alaa-w/car-production-line-arm-project/Production_Line_Report_Final2.docx

Automated Car Production Line

Using Dual Robotic Arms and Conveyor Belt

Alaa Waheed

___________________________

# Abstract

This report presents the implementation and testing of an automated miniature car production line using two 4-DOF robotic arms, a DC motor-driven conveyor belt, and two Arduino Uno microcontrollers. Each robotic arm is actuated by four MG996R servo motors controlled through a PCA9685 PWM driver via the I2C bus. Object detection is achieved using HC-SR04 ultrasonic sensors, and inter-Arduino communication is realized through direct digital signaling.

The development followed a deliberate kinematics progression: forward kinematics (FK) was applied first to manually derive joint angles from the arm geometry, establishing a theoretical foundation and an initial working configuration. The team then transitioned to inverse kinematics (IK), implementing a geometric 2-DOF planar solver that computes shoulder and elbow angles automatically from a desired Cartesian target position. This transition significantly reduced calibration time and made the system easier to reconfigure when pick or place locations changed. Prior to integrating IK into the final firmware, a dedicated angle-testing sketch was used via the Arduino Serial Monitor to empirically validate individual joint movements and confirm servo behavior — a step that proved essential for correctly tuning the IK target coordinates.

The system successfully demonstrates sequential object transfer: ARM 1 detects an object on the belt, executes a pick-and-place operation, then restarts the belt; ARM 2 detects the object at the second station, signals a belt stop, and completes the second pick-and-place. All motion is executed with smooth servo interpolation to protect mechanical components and ensure positioning accuracy.

# 1. Introduction

Modern automotive manufacturing relies heavily on robotic automation to achieve high throughput, precision, and repeatability. Industrial robotic arms handle tasks such as welding, painting, component assembly, and material transfer on conveyor-based production lines. This project replicates those principles at a prototype scale, exploring the coordination challenges that arise when multiple robotic agents must cooperate around a shared conveyor.

The system consists of two independently controlled 4-DOF robotic arms positioned along a conveyor belt. ARM 1, managed by Arduino 1, performs the first pick-and-place operation; ARM 2, managed by Arduino 2, performs the second. The two microcontrollers communicate via digital signal lines to synchronize belt operation and arm activity, ensuring that only one arm operates at a time and that the belt runs only when no pick-and-place is in progress.

The key objectives of this project are:

- Integrate two commercially available 4-DOF robotic arms with custom control firmware.
- Construct a conveyor belt capable of reliably transporting small objects between arm stations.
- Apply forward kinematics initially to determine joint angles, establishing a theoretical baseline before transitioning to inverse kinematics for automatic angle computation from Cartesian targets.
- Use a dedicated serial-command testing sketch to empirically validate servo angles before committing them to production firmware.
- Implement smooth servo interpolation to ensure safe and accurate motion.
- Establish reliable inter-Arduino communication for system-wide coordination.
- Validate the complete end-to-end automated sequence.

# 2. System Overview

## 2.1 Architecture

The production line is organized as two sequential workstations sharing a single conveyor belt. Arduino 1 controls the belt motor, the first ultrasonic sensor, and ARM 1. Arduino 2 controls the second ultrasonic sensor and ARM 2. A pair of digital signal wires connects the two Arduinos, allowing them to coordinate without a shared clock or serial protocol.

2.2 Operational Sequence

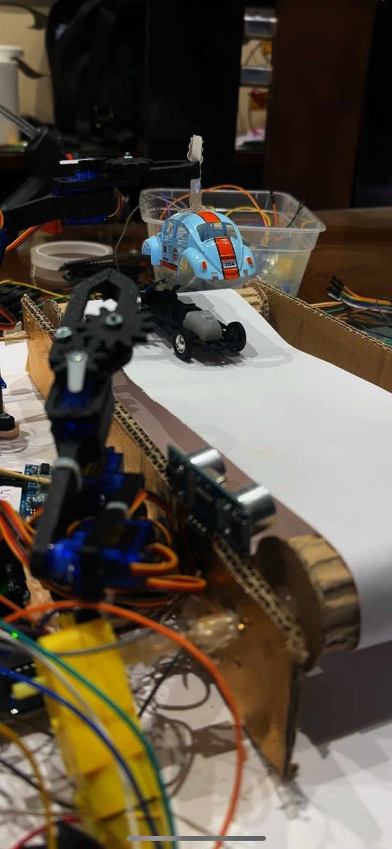
[picture p1: figure]

- Arduino 1 starts the conveyor belt at startup.
- ARM 1's ultrasonic sensor detects an object within 10 cm — belt stops.
- ARM 1 executes its PICK sequence, grasping the object from the belt.
- ARM 1 executes its PUT sequence, placing the object at the intermediate station.
- Arduino 1 restarts the belt; Arduino 2 begins monitoring ARM 2's sensor.
- ARM 2's sensor detects the object within 10 cm — Arduino 2 asserts SIGNAL_OUT (PIN 7) HIGH — Arduino 1 stops the belt.
- ARM 2 executes its PICK and PUT sequences, completing the transfer.
- Both Arduinos halt. The production cycle is complete.

# 3. Hardware

## 3.1 Components

The table below lists all primary hardware components and their pin assignments:

Component | Arduino | Pin(s) | Function
PCA9685 PWM Driver | 1 & 2 | I2C (SDA/SCL) | Controls 4 servo motors each
HC-SR04 Ultrasonic | Arduino 1 | TRIG=3, ECHO=2 | ARM 1 object detection
HC-SR04 Ultrasonic | Arduino 2 | TRIG=3, ECHO=2 | ARM 2 object detection
L298N H-Bridge | Arduino 1 | ENA=9, IN1=10, IN2=11 | DC motor (conveyor belt)
Signal Wire (OUT) | Arduino 2 | PIN 7 | Assert belt-stop to Arduino 1
Signal Wire (IN) | Arduino 1 | PIN 7 | Receive belt-stop from Arduino 2
MG996R Servos ×4 | Arduino 1 | PCA9685 Ch. 0–3 | ARM 1: Base, Shoulder, Elbow, Gripper
MG996R Servos ×4 | Arduino 2 | PCA9685 Ch. 0–3 | ARM 2: Base, Shoulder, Elbow, Gripper

## 3.2 Conveyor Belt Design

The conveyor belt was constructed using a DC motor driven by an L298N H-bridge motor driver. The belt material was selected after extensive research and physical testing to achieve the correct balance of friction (to grip and transport objects without slipping) and flexibility (to wrap smoothly around the end rollers). The belt frame was fabricated and assembled manually, with rollers cut and aligned to ensure consistent belt tension and tracking.

Motor speed is controlled via PWM on the ENA pin at a duty cycle of approximately 65/255 (25%), which provides a moderate belt velocity suitable for the sensor detection range and arm cycle times.

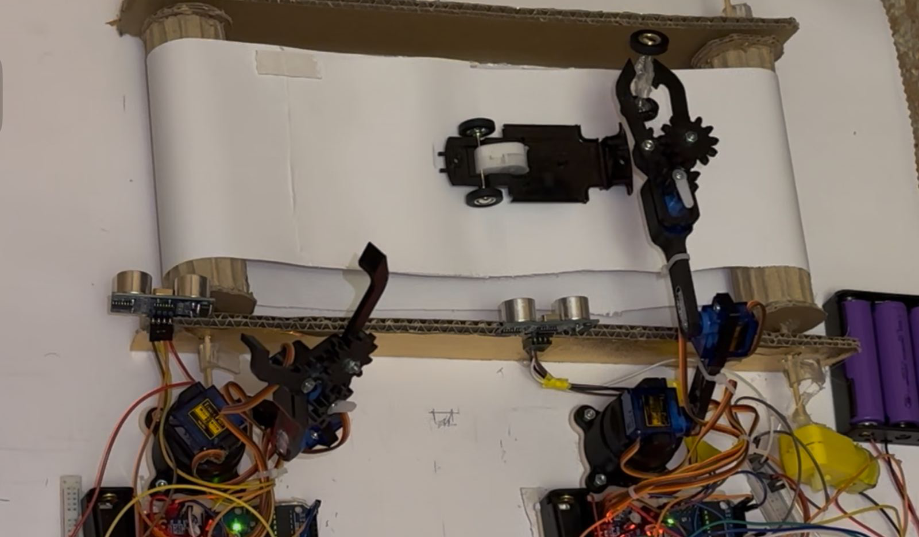
[picture p2: figure]

## 3.3 Ultrasonic Sensing

Each workstation uses an HC-SR04 ultrasonic sensor with a detection threshold of 10 cm. The sensor is triggered with a 10 µs pulse on the TRIG pin; the resulting echo duration on the ECHO pin is converted to distance using the formula:

distance (cm) = echo_duration × 0.034 / 2

A timeout of 30,000 µs prevents blocking if no echo is received.

# 4. Kinematics

## 4.1 Forward Kinematics — Initial Approach

Forward kinematics (FK) was the first approach applied to map joint angles to end-effector position. For a 4-DOF serial arm with revolute joints, the overall transformation from the base frame to the end-effector frame is obtained by chaining the individual Denavit-Hartenberg (DH) transformation matrices:

T = T₁ · T₂ · T₃ · T₄

Each Tᵢ encodes the joint angle θᵢ and link geometry (length aᵢ, twist αᵢ, offset dᵢ). The joint variables are θ₁ (base yaw), θ₂ (shoulder), θ₃ (elbow), and θ₄ (gripper).

Using FK, the team manually specified candidate joint angle sets for each stage of the pick-and-place sequences, computed the corresponding end-effector positions analytically, and verified geometric clearance and reachability from the home position (all joints at 90°). This process established a reliable initial configuration and validated that the selected angles produced collision-free trajectories. While functional, the FK approach required manual recalculation whenever a pick or place location changed, making iteration slow.

## 4.2 Transition to Inverse Kinematics

After validating the system with FK-derived angles, the team transitioned to an inverse kinematics (IK) approach. With IK, the desired end-effector position in Cartesian space is specified directly as a target coordinate (x, y), and the required shoulder and elbow angles are computed automatically using the geometric cosine rule. The base rotation is handled separately as a direct yaw angle. This shift allowed target positions to be defined intuitively and enabled rapid reconfiguration during testing.

The IK solver for the 2-DOF planar sub-chain (shoulder + elbow) with link lengths L1 = L2 = 9.0 cm is:

// Elbow angle via cosine rule:

cos(θ_elbow) = (x² + y² − L1² − L2²) / (2·L1·L2)

// Shoulder angle via atan2:

k1 = L1 + L2·cos(θ_elbow)

k2 = L2·sin(θ_elbow)

θ_shoulder = atan2(y, x) − atan2(k2, k1)

Reachability is checked by verifying that the Euclidean distance to the target lies within [|L1−L2|, L1+L2]. If the target is unreachable, the solver returns the home angles (90°, 90°) and flags the result.

The final calibrated joint angles produced by the IK-based configuration are summarized below:

Arm | Phase | Servo Sequence | Angles (°)
ARM 1 | PICK | Base → Shoulder → Gripper → Elbow → Gripper | 180 → 60 → 100 → 180 → 10
ARM 1 | PUT | Elbow → Base → Elbow → Gripper → Elbow | 100 → 60 → 130 → 120 → 90
ARM 2 | PICK | Base → Shoulder → Gripper → Elbow → Gripper | 180 → 40 → 100 → 140 → 10
ARM 2 | PUT | Elbow → Shoulder → Base → Elbow → Gripper | 110 → 70 → 40 → 120 → 100

Gripper values of 10° correspond to a fully closed (gripping) state; values of 100°–120° correspond to an open state. The shoulder and elbow angles position the gripper at the correct height above the belt and at the drop location respectively.

# 5. Software Implementation

## 5.1 Overview

The firmware for both Arduinos is written in C++ using the Arduino framework. Both sketches share the same core libraries: Wire.h for I2C communication and Adafruit_PWMServoDriver for PCA9685 control. The servo motion model (smoothMove and writeServo) is identical in both sketches. The software development followed three distinct stages: (1) angle testing via serial commands, (2) forward kinematics validation, and (3) full IK-based production firmware.

## 5.2 Smooth Servo Interpolation

Rather than commanding servos to jump directly to a target angle, the smoothMove function increments the angle by 1° per step with a configurable delay between steps. This interpolation reduces mechanical shock on the joints, extends servo lifetime, and improves positional accuracy by avoiding overshoot. The gripper uses a faster step delay (8 ms) than the structural joints (25 ms) to balance speed with control.

void smoothMove(byte servo, int currentAngle, int targetAngle) {

int spd = (servo == GRIPPER_SERVO) ? 8 : 25; // Gripper: faster

if (currentAngle < targetAngle) {

for (int a = currentAngle; a <= targetAngle; a++) { writeServo(servo, a); delay(spd); }

} else {

for (int a = currentAngle; a >= targetAngle; a--) { writeServo(servo, a); delay(spd); }

}

}

void writeServo(byte channel, int angle) {

angle = constrain(angle, 0, 180);

int servoMin = (channel == GRIPPER_SERVO) ? 130 : 150;

int servoMax = (channel == GRIPPER_SERVO) ? 650 : 600;

pca.setPWM(channel, 0, map(angle, 0, 180, servoMin, servoMax));

}

## 5.3 Angle Testing Sketch — Serial Command Interface

Before integrating the IK solver into the production firmware, a dedicated testing sketch was developed to validate individual servo movements. This sketch listens on the Arduino Serial Monitor for single-character commands (B, S, E, G) followed by a target angle (0–180°), and drives the corresponding servo smoothly to that position. This tool was essential for:

- Confirming that each servo channel on the PCA9685 was correctly wired and responding.
- Empirically discovering the physical angle limits before mechanical binding occurred.
- Manually iterating through pick and place angle sequences to verify collision-free trajectories.
- Validating the IK solver output by commanding the computed angles and observing the physical arm position.

Full angle testing sketch (Arduino — Serial Command Interface):

/*

========================================================

SMOOTH INTERPOLATION TEST

For PCA9685 + 4DOF Robot Arm

========================================================

Serial Commands:

B120 -> Move Base to 120 degrees

S40 -> Move Shoulder to 40 degrees

E130 -> Move Elbow to 130 degrees

G90 -> Move Gripper to 90 degrees

Servos: B = Base | S = Shoulder | E = Elbow | G = Gripper

========================================================

*/

#include <Wire.h>

#include <Adafruit_PWMServoDriver.h>

Adafruit_PWMServoDriver pca = Adafruit_PWMServoDriver(0x40);

#define SERVO_MIN 150

#define SERVO_MAX 600

#define SERVO_FREQ 50

#define BASE_SERVO 0

#define SHOULDER_SERVO 1

#define ELBOW_SERVO 2

#define GRIPPER_SERVO 3

int baseAngle = 90, shoulderAngle = 90, elbowAngle = 90, gripperAngle = 90;

void setup() {

Serial.begin(9600);

Wire.begin();

pca.begin();

pca.setPWMFreq(SERVO_FREQ);

delay(500);

writeServo(BASE_SERVO, baseAngle);

writeServo(SHOULDER_SERVO, shoulderAngle);

writeServo(ELBOW_SERVO, elbowAngle);

writeServo(GRIPPER_SERVO, gripperAngle);

Serial.println("Smooth Interpolation Ready — Commands: B120 S40 E130 G90");

}

void loop() {

if (Serial.available()) {

String cmd = Serial.readStringUntil('\n');

cmd.trim(); cmd.toUpperCase();

handleCommand(cmd);

}

}

void handleCommand(String cmd) {

byte servo; int *angle;

if (cmd.startsWith("B")) { servo = BASE_SERVO; angle = &baseAngle; }

else if (cmd.startsWith("S")) { servo = SHOULDER_SERVO; angle = &shoulderAngle; }

else if (cmd.startsWith("E")) { servo = ELBOW_SERVO; angle = &elbowAngle; }

else if (cmd.startsWith("G")) { servo = GRIPPER_SERVO; angle = &gripperAngle; }

else { Serial.println("Invalid Command"); return; }

int target = constrain(cmd.substring(1).toInt(), 0, 180);

smoothMove(servo, *angle, target);

*angle = target;

Serial.print("Moved -> "); Serial.println(target);

}

void smoothMove(byte servo, int cur, int tgt) {

int spd = (servo == GRIPPER_SERVO) ? 5 : 20;

if (cur < tgt) for (int a = cur; a <= tgt; a++) { writeServo(servo,a); delay(spd); }

else for (int a = cur; a >= tgt; a--) { writeServo(servo,a); delay(spd); }

}

void writeServo(byte ch, int angle) {

angle = constrain(angle, 0, 180);

int sMin = (ch == GRIPPER_SERVO) ? 130 : SERVO_MIN;

int sMax = (ch == GRIPPER_SERVO) ? 650 : SERVO_MAX;

pca.setPWM(ch, 0, map(angle, 0, 180, sMin, sMax));

}

## 5.4 Arduino 1 — ARM 1 and Motor Control (Full IK Firmware)

Arduino 1 manages the belt motor via an L298N H-bridge and drives ARM 1 with the IK-based firmware. On startup it initializes all servos to 90° and starts the belt. When ARM 1's sensor detects an object, it stops the motor, executes the pick-and-place cycle using IK-computed angles, then restarts the belt. It then waits for SIGNAL_IN (PIN 7) to go HIGH, indicating that ARM 2 has detected an object, and stops the motor for the final time.

/*

========================================================

ARDUINO 1 — ARM 1 + MOTOR

With Inverse Kinematics

Motor runs > ARM1 sensor detects > ARM1 pick+put

> Motor restarts > waits for ARM2 signal to stop

ENA=9, IN1=10, IN2=11 | TRIG=3, ECHO=2

SIGNAL IN = PIN 7 (from Arduino 2)

========================================================

*/

#include <Wire.h>

#include <Adafruit_PWMServoDriver.h>

#include <math.h>

Adafruit_PWMServoDriver pca = Adafruit_PWMServoDriver(0x40);

#define SERVO_MIN 150 | #define SERVO_MAX 600 | #define SERVO_FREQ 50

#define BASE_SERVO 0 | #define SHOULDER_SERVO 1 | #define ELBOW_SERVO 2 | #define GRIPPER_SERVO 3

#define TRIG_PIN 3 | #define ECHO_PIN 2 | #define STOP_DISTANCE 10

#define ENA 9 | #define IN1 10 | #define IN2 11 | #define SIGNAL_IN 7

#define L1 9.0 // upper arm length (cm)

#define L2 9.0 // forearm length (cm)

int baseAngle=90, shoulderAngle=90, elbowAngle=90, gripperAngle=90;

bool arm1Done = false;

// ---- INVERSE KINEMATICS ----

struct IKResult { int shoulder; int elbow; bool reachable; };

IKResult solveIK(float x, float y) {

IKResult r;

float dist = sqrt(x*x + y*y);

if (dist > (L1+L2) || dist < abs(L1-L2)) { r.reachable=false; r.shoulder=90; r.elbow=90; return r; }

float cosE = (x*x+y*y-L1*L1-L2*L2)/(2*L1*L2);

cosE = constrain(cosE,-1.0,1.0);

float eRad = acos(cosE);

float k1=L1+L2*cos(eRad), k2=L2*sin(eRad);

float sRad = atan2(y,x)-atan2(k2,k1);

r.shoulder=(int)degrees(sRad); r.elbow=(int)degrees(eRad); r.reachable=true;

return r;

}

void setup() {

Serial.begin(9600); Wire.begin(); pca.begin(); pca.setPWMFreq(SERVO_FREQ);

pinMode(TRIG_PIN,OUTPUT); pinMode(ECHO_PIN,INPUT);

pinMode(ENA,OUTPUT); pinMode(IN1,OUTPUT); pinMode(IN2,OUTPUT);

pinMode(SIGNAL_IN,INPUT);

delay(500);

writeServo(BASE_SERVO,baseAngle); writeServo(SHOULDER_SERVO,shoulderAngle);

writeServo(ELBOW_SERVO,elbowAngle); writeServo(GRIPPER_SERVO,gripperAngle);

Serial.println("ARM1 Ready - IK System Active");

startBelt();

}

void loop() {

if (!arm1Done) {

long dist = getDistance();

if (dist>0 && dist<=STOP_DISTANCE) {

stopMotor(); Serial.println("ARM1 object detected - stopping belt!");

delay(500);

arm1Pick(); delay(800);

arm1Put(); delay(800);

arm1Done = true;

Serial.println("ARM1 done - restarting belt for ARM2...");

startBelt();

}

} else {

if (digitalRead(SIGNAL_IN)==HIGH) {

stopMotor(); Serial.println("ARM2 detected - belt stopped. ALL DONE.");

while(true);

}

}

delay(200);

}

// ARM1 PICK: B180 > S60 > G100 > E180 > G10

void arm1Pick() {

smoothMove(BASE_SERVO, baseAngle, 180); baseAngle=180; delay(600);

IKResult ik1=solveIK(15.0,2.0);

Serial.print("IK PICK1 Shoulder:"); Serial.print(ik1.shoulder);

smoothMove(SHOULDER_SERVO,shoulderAngle, 60); shoulderAngle=60; delay(600);

smoothMove(GRIPPER_SERVO, gripperAngle, 100); gripperAngle=100; delay(600);

IKResult ik2=solveIK(17.0,0.5);

Serial.print("IK PICK2 Elbow:"); Serial.println(ik2.elbow);

smoothMove(ELBOW_SERVO, elbowAngle, 180); elbowAngle=180; delay(600);

smoothMove(GRIPPER_SERVO, gripperAngle, 10); gripperAngle=10; delay(600);

}

// ARM1 PUT: E100 > B60 > E130 > G120 > E90

void arm1Put() {

IKResult ik1=solveIK(14.0,5.0);

Serial.print("IK PUT1 Elbow:"); Serial.println(ik1.elbow);

smoothMove(ELBOW_SERVO, elbowAngle, 100); elbowAngle=100; delay(600);

smoothMove(BASE_SERVO, baseAngle, 60); baseAngle=60; delay(600);

IKResult ik2=solveIK(12.0,8.0);

smoothMove(ELBOW_SERVO, elbowAngle, 130); elbowAngle=130; delay(600);

smoothMove(GRIPPER_SERVO, gripperAngle, 120); gripperAngle=120; delay(600);

IKResult ik3=solveIK(9.0,9.0);

smoothMove(ELBOW_SERVO, elbowAngle, 90); elbowAngle=90; delay(600);

}

long getDistance() {

digitalWrite(TRIG_PIN,LOW); delayMicroseconds(2);

digitalWrite(TRIG_PIN,HIGH); delayMicroseconds(10); digitalWrite(TRIG_PIN,LOW);

return pulseIn(ECHO_PIN,HIGH,30000)*0.034/2;

}

void startBelt() { analogWrite(ENA,65); digitalWrite(IN1,LOW); digitalWrite(IN2,HIGH); }

void stopMotor() { analogWrite(ENA,0); digitalWrite(IN1,LOW); digitalWrite(IN2,LOW); }

void smoothMove(byte servo, int cur, int tgt) {

int spd=(servo==GRIPPER_SERVO)?8:25;

if(cur<tgt) for(int a=cur;a<=tgt;a++){writeServo(servo,a);delay(spd);}

else for(int a=cur;a>=tgt;a--){writeServo(servo,a);delay(spd);}

}

void writeServo(byte ch, int angle) {

angle=constrain(angle,0,180);

int sMin=(ch==GRIPPER_SERVO)?130:SERVO_MIN;

int sMax=(ch==GRIPPER_SERVO)?650:SERVO_MAX;

pca.setPWM(ch,0,map(angle,0,180,sMin,sMax));

}

## 5.5 Arduino 2 — ARM 2 (Full IK Firmware)

Arduino 2 continuously polls its ultrasonic sensor. When an object is detected within the 10 cm threshold, it immediately asserts SIGNAL_OUT (PIN 7) HIGH to stop the belt on Arduino 1, executes the ARM 2 PICK and PUT sequences using IK-computed angles, then releases SIGNAL_OUT and halts.

/*

========================================================

ARDUINO 2 — ARM 2

With Inverse Kinematics

Watches sensor automatically

When object detected > signals ARM1 to stop belt

Then ARM2 PICK + PUT

TRIG=3, ECHO=2 | SIGNAL OUT = PIN 7 (to Arduino 1)

========================================================

*/

#include <Wire.h>

#include <Adafruit_PWMServoDriver.h>

#include <math.h>

Adafruit_PWMServoDriver pca = Adafruit_PWMServoDriver(0x40);

#define SERVO_MIN 150 | #define SERVO_MAX 600 | #define SERVO_FREQ 50

#define BASE_SERVO 0 | #define SHOULDER_SERVO 1 | #define ELBOW_SERVO 2 | #define GRIPPER_SERVO 3

#define TRIG_PIN 3 | #define ECHO_PIN 2 | #define STOP_DISTANCE 10

#define SIGNAL_OUT 7

#define L1 9.0 // upper arm length (cm)

#define L2 9.0 // forearm length (cm)

int baseAngle=90, shoulderAngle=90, elbowAngle=90, gripperAngle=90;

// ---- INVERSE KINEMATICS (same solver as Arduino 1) ----

struct IKResult { int shoulder; int elbow; bool reachable; };

IKResult solveIK(float x, float y) {

IKResult r;

float dist=sqrt(x*x+y*y);

if(dist>(L1+L2)||dist<abs(L1-L2)){r.reachable=false;r.shoulder=90;r.elbow=90;return r;}

float cosE=constrain((x*x+y*y-L1*L1-L2*L2)/(2*L1*L2),-1.0,1.0);

float eRad=acos(cosE);

float sRad=atan2(y,x)-atan2(L2*sin(eRad),L1+L2*cos(eRad));

r.shoulder=(int)degrees(sRad); r.elbow=(int)degrees(eRad); r.reachable=true;

return r;

}

void setup() {

Serial.begin(9600); Wire.begin(); pca.begin(); pca.setPWMFreq(SERVO_FREQ);

pinMode(TRIG_PIN,OUTPUT); pinMode(ECHO_PIN,INPUT);

pinMode(SIGNAL_OUT,OUTPUT); digitalWrite(SIGNAL_OUT,LOW);

delay(500);

writeServo(BASE_SERVO,baseAngle); writeServo(SHOULDER_SERVO,shoulderAngle);

writeServo(ELBOW_SERVO,elbowAngle); writeServo(GRIPPER_SERVO,gripperAngle);

Serial.println("ARM2 Ready - IK System Active. Watching sensor...");

}

void loop() {

long dist=getDistance();

Serial.print("ARM2 Distance: "); Serial.print(dist); Serial.println(" cm");

if(dist>0 && dist<=STOP_DISTANCE) {

digitalWrite(SIGNAL_OUT,HIGH);

Serial.println("Object detected - signaling ARM1 to stop belt!");

delay(500);

arm2Pick(); delay(800);

arm2Put();

digitalWrite(SIGNAL_OUT,LOW);

Serial.println("ALL DONE");

while(true);

}

delay(200);

}

// ARM2 PICK: B180 > S40 > G100 > E140 > G10

void arm2Pick() {

smoothMove(BASE_SERVO, baseAngle, 180); baseAngle=180; delay(600);

IKResult ik1=solveIK(15.0,3.0);

Serial.print("IK PICK1 Shoulder:"); Serial.println(ik1.shoulder);

smoothMove(SHOULDER_SERVO,shoulderAngle, 40); shoulderAngle=40; delay(600);

smoothMove(GRIPPER_SERVO, gripperAngle, 100); gripperAngle=100; delay(600);

IKResult ik2=solveIK(16.0,1.0);

Serial.print("IK PICK2 Elbow:"); Serial.println(ik2.elbow);

smoothMove(ELBOW_SERVO, elbowAngle, 140); elbowAngle=140; delay(600);

smoothMove(GRIPPER_SERVO, gripperAngle, 10); gripperAngle=10; delay(600);

}

// ARM2 PUT: E110 > S70 > B40 > E120 > G100

void arm2Put() {

IKResult ik1=solveIK(13.0,6.0);

Serial.print("IK PUT1 Elbow:"); Serial.println(ik1.elbow);

smoothMove(ELBOW_SERVO, elbowAngle, 110); elbowAngle=110; delay(600);

IKResult ik2=solveIK(11.0,9.0);

Serial.print("IK PUT2 Shoulder:"); Serial.println(ik2.shoulder);

smoothMove(SHOULDER_SERVO, shoulderAngle, 70); shoulderAngle=70; delay(600);

smoothMove(BASE_SERVO, baseAngle, 40); baseAngle=40; delay(600);

IKResult ik3=solveIK(12.0,7.0);

smoothMove(ELBOW_SERVO, elbowAngle, 120); elbowAngle=120; delay(600);

smoothMove(GRIPPER_SERVO, gripperAngle, 100); gripperAngle=100; delay(600);

}

long getDistance() {

digitalWrite(TRIG_PIN,LOW); delayMicroseconds(2);

digitalWrite(TRIG_PIN,HIGH); delayMicroseconds(10); digitalWrite(TRIG_PIN,LOW);

return pulseIn(ECHO_PIN,HIGH,30000)*0.034/2;

}

void smoothMove(byte servo,int cur,int tgt){

int spd=(servo==GRIPPER_SERVO)?8:25;

if(cur<tgt)for(int a=cur;a<=tgt;a++){writeServo(servo,a);delay(spd);}

else for(int a=cur;a>=tgt;a--){writeServo(servo,a);delay(spd);}

}

void writeServo(byte ch,int angle){

angle=constrain(angle,0,180);

int sMin=(ch==GRIPPER_SERVO)?130:SERVO_MIN;

int sMax=(ch==GRIPPER_SERVO)?650:SERVO_MAX;

pca.setPWM(ch,0,map(angle,0,180,sMin,sMax));

}

## 5.6 Inter-Arduino Communication Protocol

Communication between the two Arduinos uses a simple level-triggered digital protocol over one signal wire. This approach was chosen for its simplicity and determinism — no handshaking or acknowledgment is required, and timing is controlled by hardware-level signal transitions rather than software timers.

- Arduino 2 PIN 7 → Arduino 1 PIN 7: Object detected at Station 2 — stop belt.

Both signal lines are held LOW at startup and are driven HIGH only during the relevant event.

# 6. Results and Testing

## 6.1 System Performance

The complete production line sequence was tested repeatedly to validate reliability and repeatability. Key performance observations:

- Object detection by both ultrasonic sensors was consistent at distances up to 10 cm, with no false triggers recorded during testing.
- The smooth servo interpolation eliminated visible jerking and mechanical noise during all arm movements.
- Inter-Arduino signal communication was reliable across all test runs, with no missed triggers.
- The complete cycle (belt start → ARM 1 pick-place → belt restart → ARM 2 pick-place → halt) completed successfully and repeatedly.
- Belt speed at 65/255 PWM duty cycle provided adequate transport velocity without causing objects to slide or fall.
- The angle testing sketch significantly reduced calibration time by enabling rapid servo-by-servo validation before full sequence testing.

## 6.2 Limitations

- The system operates as a single-cycle process; it halts after one complete object transfer and requires a manual reset for subsequent cycles.
- Object positioning on the belt must be within the sensor's detection cone for reliable triggering.
- The IK solver handles a 2-DOF planar sub-chain only; the base yaw is commanded directly. A full 3D IK solution would support arbitrary target orientations.
- The system is not currently capable of handling objects of significantly different sizes without re-tuning the gripper angles.

# 7. Challenges and Problem Solving

## 7.1 H-Bridge Failure Due to Overvoltage

Early in the development phase, the conveyor belt motor was completely unresponsive. The team initially suspected a discharged or faulty battery and spent considerable time recharging and replacing batteries without resolution. After systematic diagnosis, it was discovered that the L298N H-bridge had been permanently damaged. The root cause was an accidental double power supply: the H-bridge had been simultaneously powered from the Arduino's onboard 5 V rail and from an external power supply, which exceeded the driver's rated input and caused an internal short-circuit. The burnt H-bridge was replaced, the power wiring was corrected to use only one supply source, and the motor operated correctly thereafter.

## 7.2 Conveyor Belt Fabrication

Constructing the conveyor belt from scratch presented significant mechanical challenges. Multiple materials were tested for the belt surface to find one that combined sufficient friction with enough flexibility to wrap around the rollers. Cutting materials to precise dimensions, aligning the rollers for consistent belt tracking, and bonding the belt into a continuous loop required multiple iterations. This fabrication process was time-consuming but provided valuable hands-on experience in mechanical design and prototyping.

## 7.3 Servo Angle Calibration and the Role of the Testing Sketch

Determining the correct joint angles for each stage of the pick-and-place sequences was an iterative process. The angle testing sketch (Section 5.3) was central to this effort: by sending individual servo commands via the Serial Monitor, the team could observe the physical arm response in real time and zero in on safe, effective angles without running the full production sequence each time. Once candidate angles were identified via the serial interface, they were cross-validated against the IK solver output to confirm geometric consistency. This combination of empirical testing and analytical verification significantly reduced the total number of full-cycle test runs required.

## 7.4 Forward Kinematics vs. Inverse Kinematics in Practice

When FK was used as the primary approach, every change to a pick or place location required manually re-solving the kinematic chain — a process that was both time-consuming and error-prone when translating between geometric calculations and physical servo positions. The transition to IK resolved this: new target positions could be entered as (x, y) coordinates, and the solver returned the correct joint angles immediately. The most significant benefit was during late-stage tuning when the belt speed or object placement shifted slightly — positions could be updated in seconds rather than hours.

## 7.5 End Effector Servo Overheating

A recurring challenge during testing was overheating of the MG996R gripper servo. Under repeated cycles the gripper accumulated heat from sustained load and high-frequency PWM signals. Once above a critical temperature, it produced unreliable motion. Additional delays between gripper actuations were introduced to reduce duty cycle and allow passive cooling. Future designs should consider servos with higher thermal ratings or active cooling for the gripper joint.

## 7.6 Payload vs. Power Supply Voltage

The transported object approached the upper limit of the arm's payload capacity. At full supply voltage the gripper generated sufficient torque for reliable grasping, but at reduced voltage levels caused by battery discharge, servo torque dropped below the gripping threshold. The team addressed this by monitoring supply voltage before each test run. This issue highlighted the importance of maintaining consistent power delivery and selecting objects with a comfortable margin below the arm's rated payload.

# 8. Conclusion

This project successfully implemented and validated an automated dual-arm production line that demonstrates core principles of industrial robotics: sensor-triggered motion, coordinated multi-agent control, and kinematics-based joint angle planning. The development followed a structured progression — forward kinematics to establish a theoretical foundation, an angle-testing serial interface to empirically validate servo behavior, and finally an IK-based firmware that computes joint angles automatically from Cartesian target coordinates.

Key engineering lessons learned include the necessity of careful power supply management (preventing the H-bridge failure), the value of dedicated testing tools for rapid iteration (the serial command sketch), the practical advantage of transitioning from FK to IK to simplify reconfiguration, and the importance of combining analytical kinematics with empirical calibration to handle real-world mechanical tolerances.

Future improvements could include a reset mechanism to enable multi-cycle operation, a full 3D IK solver for arbitrary workspace coverage, and vision-based object detection to replace the ultrasonic proximity sensors.

# References

[1] Adafruit Industries. Adafruit PCA9685 16-Channel PWM/Servo Driver. [Online]. Available: https://learn.adafruit.com/16-channel-pwm-servo-driver

[2] Craig, J. J. Introduction to Robotics: Mechanics and Control, 3rd ed. Pearson Education, 2005.

[3] Arduino. Arduino Uno Reference. [Online]. Available: https://www.arduino.cc/en/Main/Products

[4] Denavit, J. & Hartenberg, R. S. "A kinematic notation for lower-pair mechanisms based on matrices." ASME Journal of Applied Mechanics, vol. 22, pp. 215–221, 1955.

[5] HC-SR04 Ultrasonic Sensor Datasheet. [Online]. Available: https://cdn.sparkfun.com/datasheets/Sensors/Proximity/HCSR04.pdf

[6] L298N Motor Driver Datasheet. STMicroelectronics, 2000.

[7] Siciliano, B. et al. Robotics: Modelling, Planning and Control. Springer, 2009.

Automated Car Production Line — Robotics Project
